Spaceflakes/250W-buck-converter/images/irl/README.md

# Hardware Photography Gallery (IRL Images)

This directory contains real-world photography of the **PUDGALA 300** synchronous buck converter across fabrication, inspection, and SMD assembly.

| Filename | Description |
| :--- | :--- |
| [`pcb_bare_board.jpg`](pcb_bare_board.jpg) | Studio shot of the unpopulated 6-layer ENIG PCB |
| [`pcb_smd_assembled.jpg`](pcb_smd_assembled.jpg) | Populated SMD board post-reflow |
| [`pcb_signature_detail.jpg`](pcb_signature_detail.jpg) | Macro closeup of "Sid J" signature and PUDGALA 300 copper etching |
| [`pcb_motto_detail.jpg`](pcb_motto_detail.jpg) | Macro closeup of *"Ex umbra, in solem."*, fan pads, and thermal vias |
| [`microscope_solder_paste_qfn.jpg`](microscope_solder_paste_qfn.jpg) | Optical microscope view of solder paste on the VQFN-24 footprint |
