Spaceflakes/250W-buck-converter/250W Bat/board.step

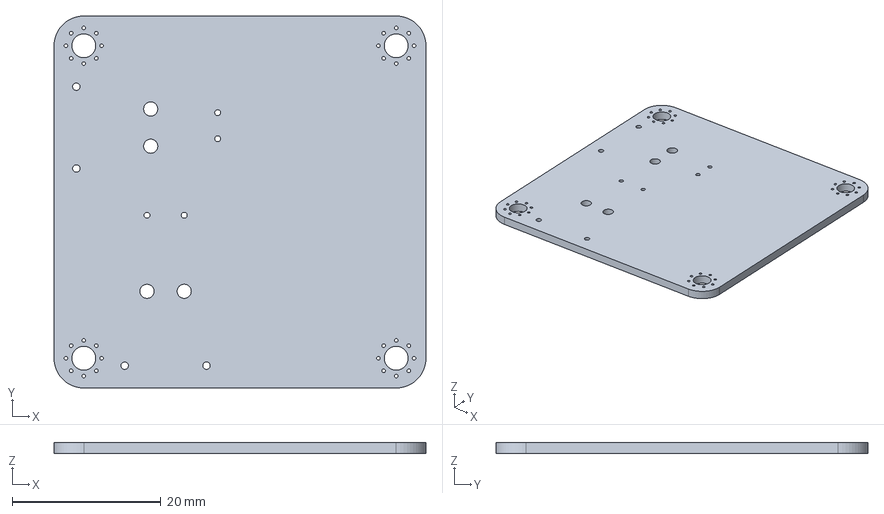
[picture p9: CAD file, 2026-10-07]
250W Bat/board.step
50.0 x 50.0 x 1.51 mm
