Spaceflakes/250W-buck-converter/250W Bat/Converter.step

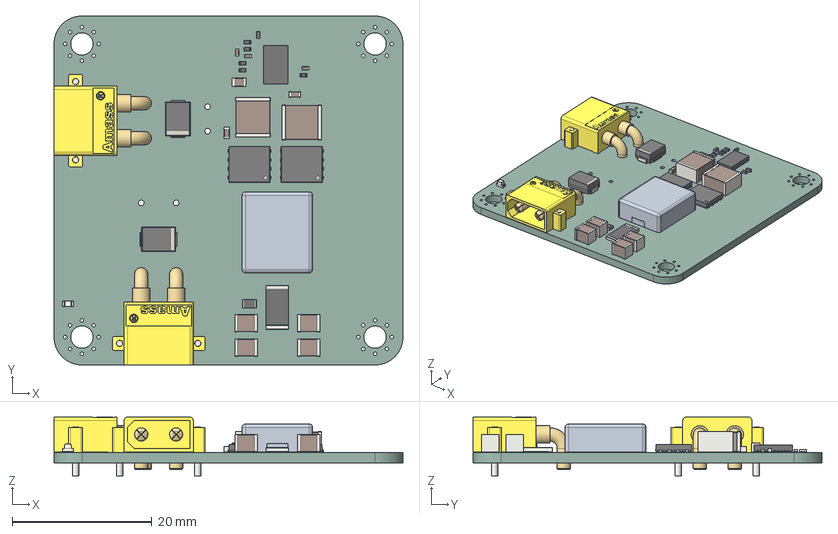
[picture p10: CAD file, 2026-10-07]
250W Bat/Converter.step
50.0 x 50.0 x 8.45 mm
R_0402_1005Metric x 6
C_0603_1608Metric x 2
C_1210_3225Metric x 4
C_2220_5750Metric x 2
C_0402_1005Metric x 3
LED_0603_1608Metric
TDSON-8-1 x 2
R_0805_2012Metric
C_0805_2012Metric
wing board 1.20.1
R_2512_6332Metric
D_SMB x 2
Amass_XT30PW-M_pcb solder x 2
250W Bat_PCB
