Spaceflakes/250W-buck-converter/250W Bat/250W Bat.kicad_pcb

## KiCad design 250W Bat/250W Bat.kicad_pcb (2026-10-07)

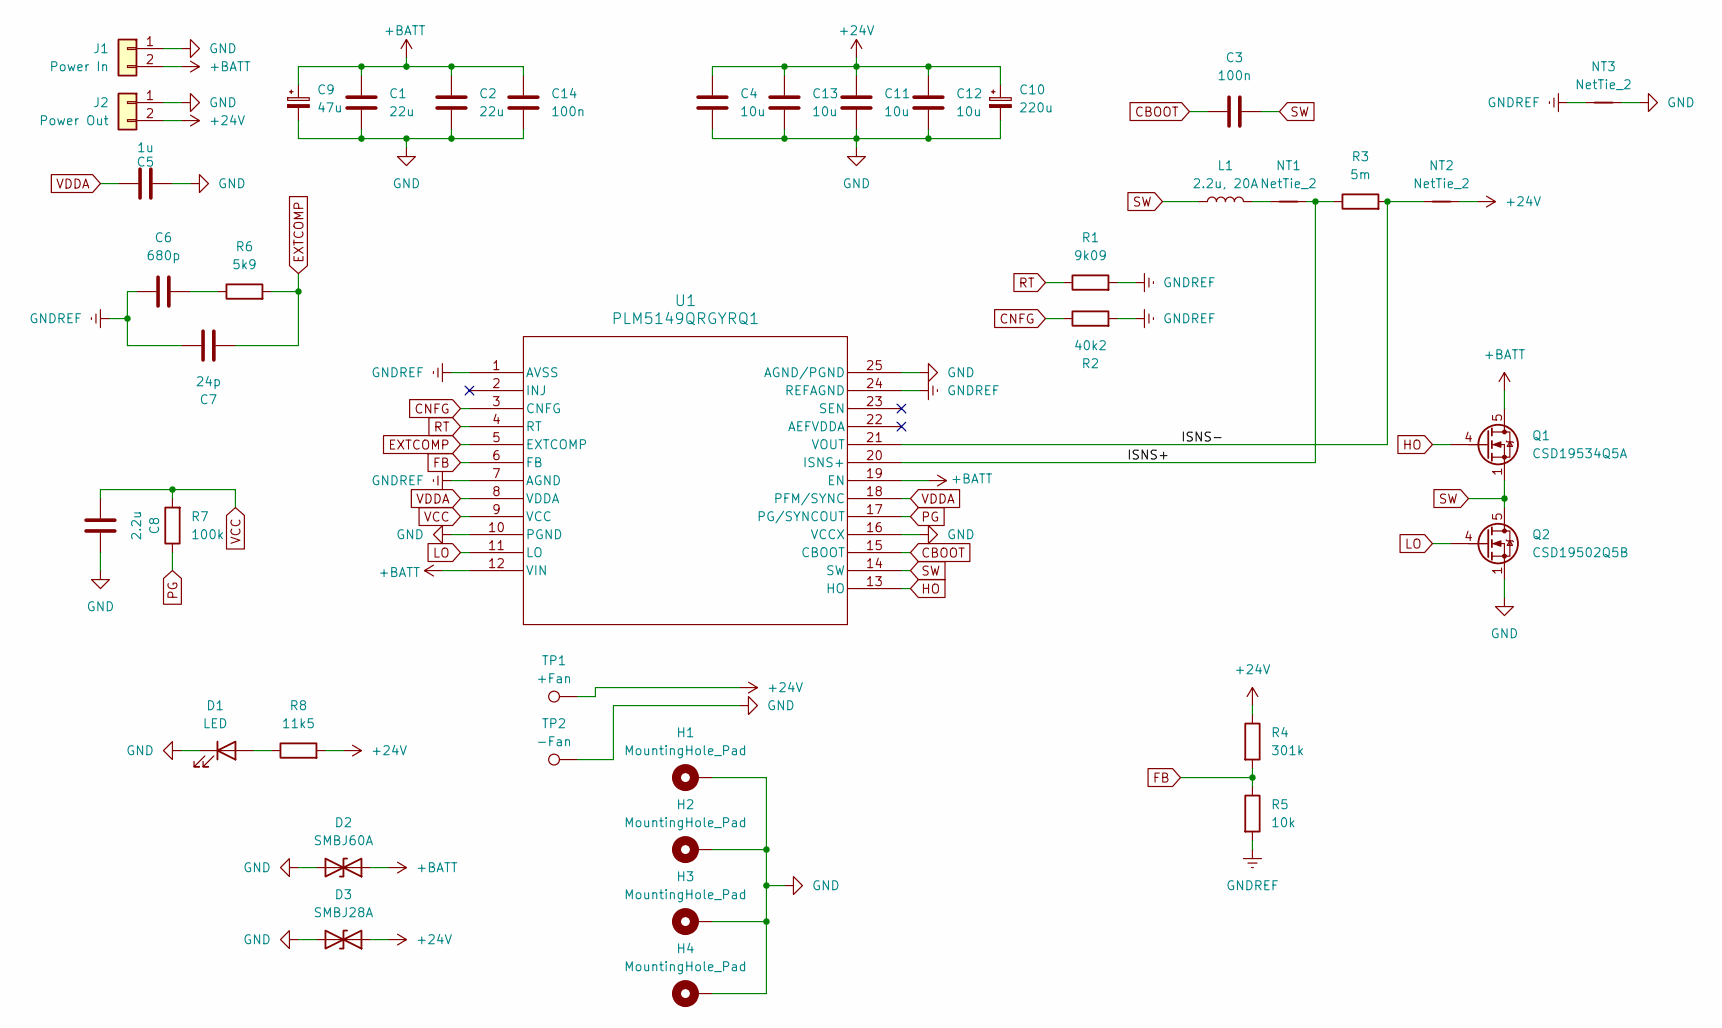
[picture p11: schematic 250W Bat.kicad_sch]

Parts:
C1, C2: 22u; C_2220_5750Metric; LCSC C7499406
C3: 100n; C_0603_1608Metric; LCSC C15725
C4, C11, C12, C13: 10u; C_1210_3225Metric; LCSC C77102
C5: 1u; C_0402_1005Metric; LCSC C29266
C6: 680p; C_0402_1005Metric
C7: 24p; C_0402_1005Metric; LCSC C2171081
C8: 2.2u; C_0805_2012Metric; LCSC C170101
C9: 47u; CP_8x15mm_horiz-R; LCSC C5110663
C10: 220u; CP_10x16mm_horiz-R; LCSC C95082
C14: 100n; C_0603_1608Metric; LCSC C7499406
D1: LED; LED_0603_1608Metric; LCSC C46610608
D2: SMBJ60A; D_SMB
D3: SMBJ28A; D_SMB
H1, H2, H3, H4: MountingHole_Pad; MountingHole_3.2mm_M3_Pad_Via
J1: Power In; AMASS_XT30PW-M_1x02_P2.50mm_Horizontal
J2: Power Out; AMASS_XT30PW-M_1x02_P2.50mm_Horizontal
L1: 2.2u, 20A; L_Chilisin_BMRF00101040; LCSC C3002681
NT1, NT2: NetTie_2; NetTie-2_SMD_Pad2.0mm
NT3: NetTie_2; NetTie-2_SMD_Pad0.5mm
Q1: CSD19534Q5A; TDSON-8-1; LCSC C114200
Q2: CSD19502Q5B; TDSON-8-1; LCSC C2864118
R1: 9k09; R_0402_1005Metric; LCSC C861611
R2: 40k2; R_0402_1005Metric; LCSC C491131
R3: 5m; R_2512_6332Metric; LCSC C48982662
R4: 301k; R_0402_1005Metric; LCSC C2981491
R5: 10k; R_0402_1005Metric; LCSC C95204
R6: 5k9; R_0402_1005Metric; LCSC C491142
R7: 100k; R_0402_1005Metric; LCSC C122538
R8: 11k5; R_0805_2012Metric
TP1: +Fan; TestPoint_Keystone_5015_Micro_Mini
TP2: -Fan; TestPoint_Keystone_5015_Micro_Mini
U1: PLM5149QRGYRQ1; VQFN24_RGY_TEX; LCSC C7528454

Connections:
+24V: C4.1, C10.1, C11.1, C12.1, C13.1, D3.1 (A1), J2.2, NT2.2, R4.1, R8.2, TP1.1; also elsewhere on the board
+BATT: C1.1, C2.1, C9.1, C14.1, D2.1 (A1), J1.2, Q1.5 (D), U1.12 (VIN), U1.19 (EN)
/ISNS+: NT1.2, R3.1, U1.20 (ISNS+)
/ISNS-: NT2.1, R3.2, U1.21 (VOUT)
CBOOT: C3.1, U1.15 (CBOOT)
CNFG: R2.1, U1.3 (CNFG)
EXTCOMP: C7.2, R6.2, U1.5 (EXTCOMP)
FB: R4.2, R5.1, U1.6 (FB)
GND: C1.2, C2.2, C4.2, C5.1, C8.2, C9.2, C10.2, C11.2, C12.2, C13.2, C14.2, D1.1 (K), D2.2 (A2), D3.2 (A2), H1.1 (1_1), H2.1 (1_1), H3.1 (1_1), H4.1 (1_1), J1.1, J2.1, NT3.2, Q2.1 (S), Q2.2 (S), Q2.3 (S), TP2.1, U1.10 (PGND), U1.16 (VCCX), U1.25 (AGND/PGND); also elsewhere on the board
GNDREF: C6.1, C7.1, NT3.1, R1.2, R2.2, R5.2, U1.1 (AVSS), U1.7 (AGND), U1.24 (REFAGND)
HO: Q1.4 (G), U1.13 (HO)
LO: Q2.4 (G), U1.11 (LO)
unnamed: C6.2, R6.1
unnamed: D1.2 (A), R8.1
unnamed: L1.2, NT1.1
PG: R7.1, U1.17 (PG/SYNCOUT)
RT: R1.1, U1.4 (RT)
SW: C3.2, L1.1, Q1.1 (S), Q1.2 (S), Q1.3 (S), Q2.5 (D), U1.14 (SW)
VCC: C8.1, R7.2, U1.9 (VCC)
VDDA: C5.2, U1.8 (VDDA), U1.18 (PFM/SYNC)

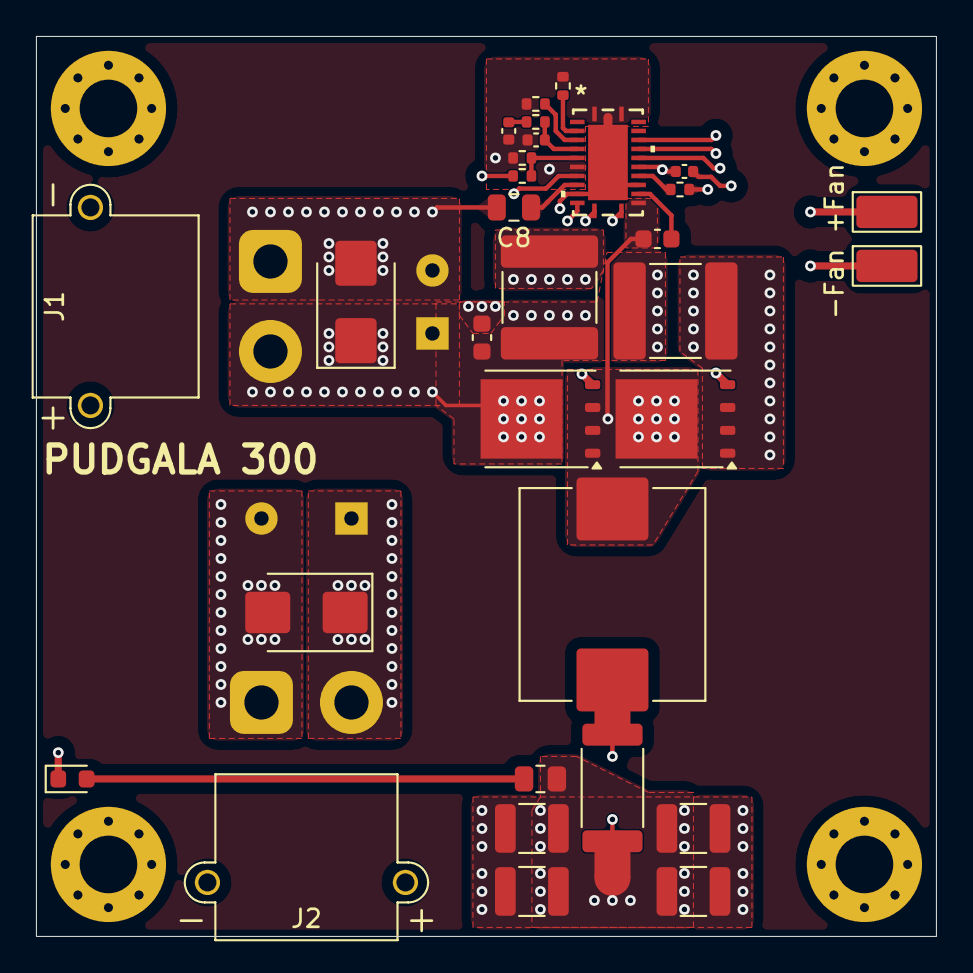
[picture p12: board 250W Bat.kicad_pcb from above]

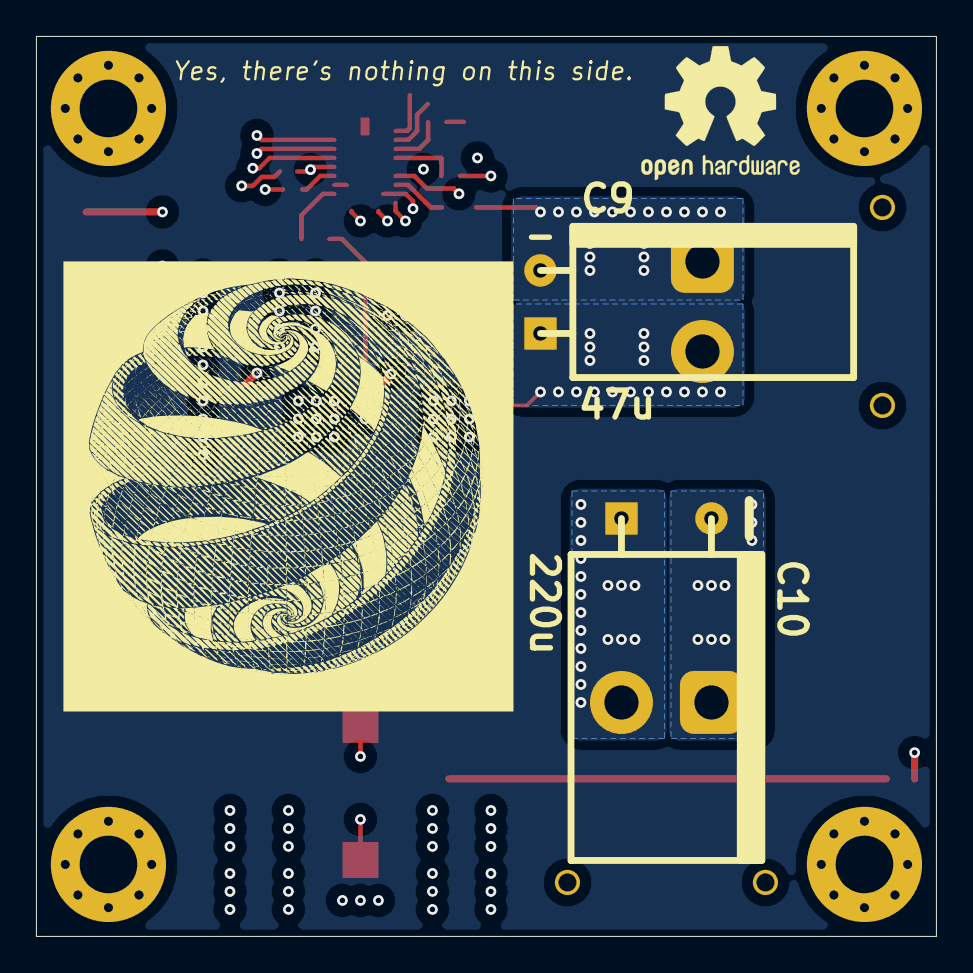
[picture p13: board 250W Bat.kicad_pcb from below]

Board: 6 copper layers, 50.0 x 50.0 mm, 40 parts (2 on the bottom side), 20 nets.

Other parts of the board:
+Fan: +Fan; TestPoint_Keystone_5015_Micro_Mini
-Fan: -Fan; TestPoint_Keystone_5015_Micro_Mini

Their connections:
+24V: +Fan.1 (1_1); also elsewhere on the board
GND: -Fan.1 (1_1); also elsewhere on the board
